JeanLeBris/Drone-Magnetic-Telepropulsion/README.md

# Télépropulsion magnétique

Réalisé par [Jean LE BRIS](https://github.com/JeanLeBris) et [Ewen MORVAN](https://github.com/EwenMorvan)

Teleprop_Technique

Pour obtenir les models 3d du système, cliquez [ici](https://grabcad.com/library/tele-propulsion-et-telecommande-magnetique-de-drones-de-surface-1).
