JeanLeBris/Drone-Magnetic-Telepropulsion/Documents/Images/ESP32 - pins - input.png

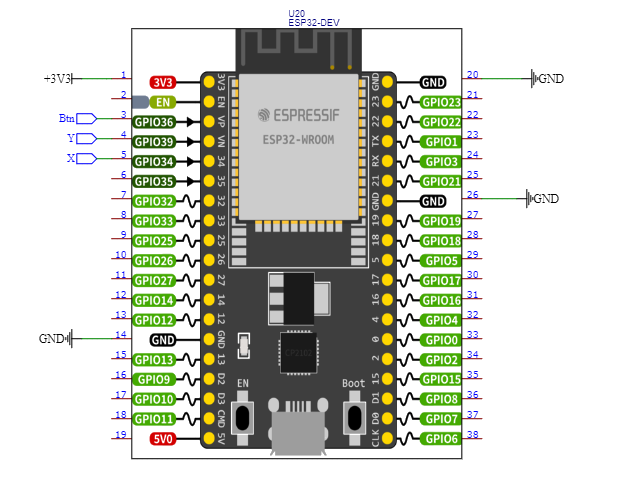
Documents/Images/ESP32 - pins - input.png
