JeanLeBris/Drone-Magnetic-Telepropulsion/Documents/Images/GifChampTournant/Proto1Img0.png

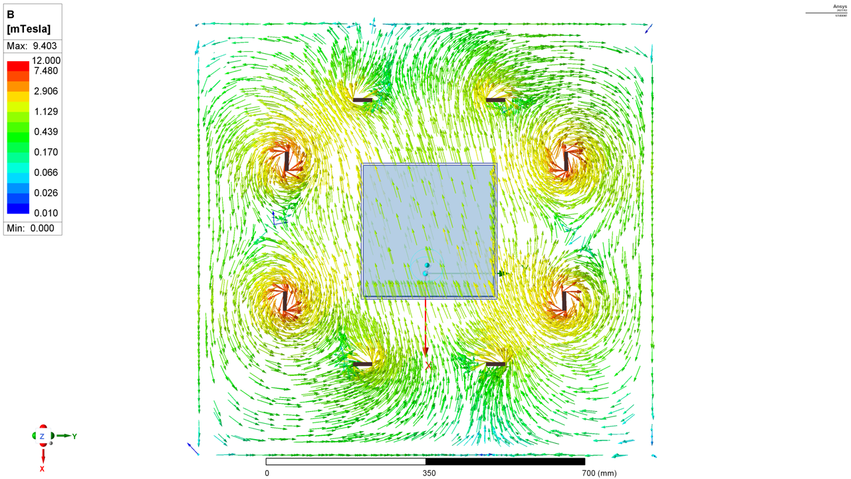
Documents/Images/GifChampTournant/Proto1Img0.png
