JeanLeBris/Drone-Magnetic-Telepropulsion/Documents/Images/GifChampTournant/Proto1Img8.png

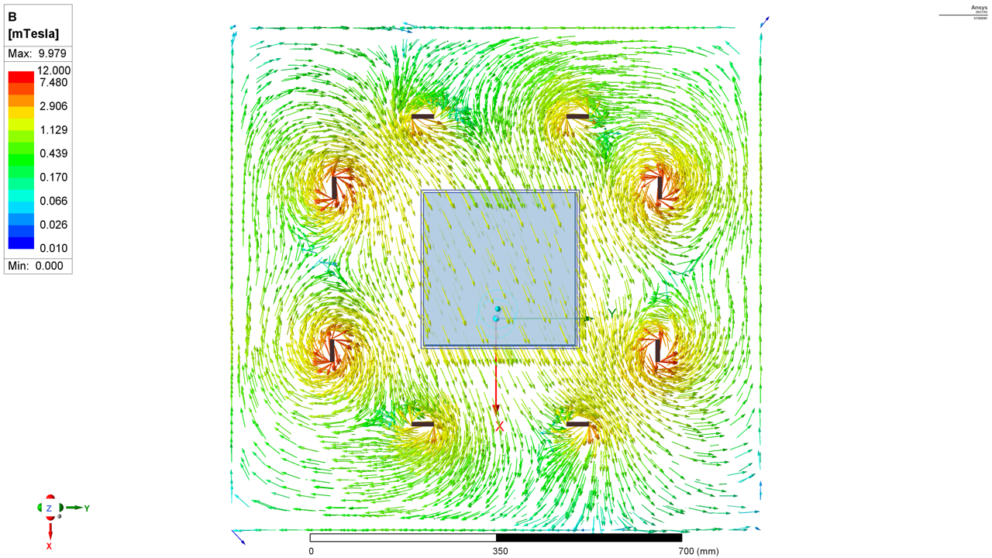
Documents/Images/GifChampTournant/Proto1Img8.png
