JeanLeBris/Drone-Magnetic-Telepropulsion/Documents/Images/GifChampTournant/Proto1Img10.png

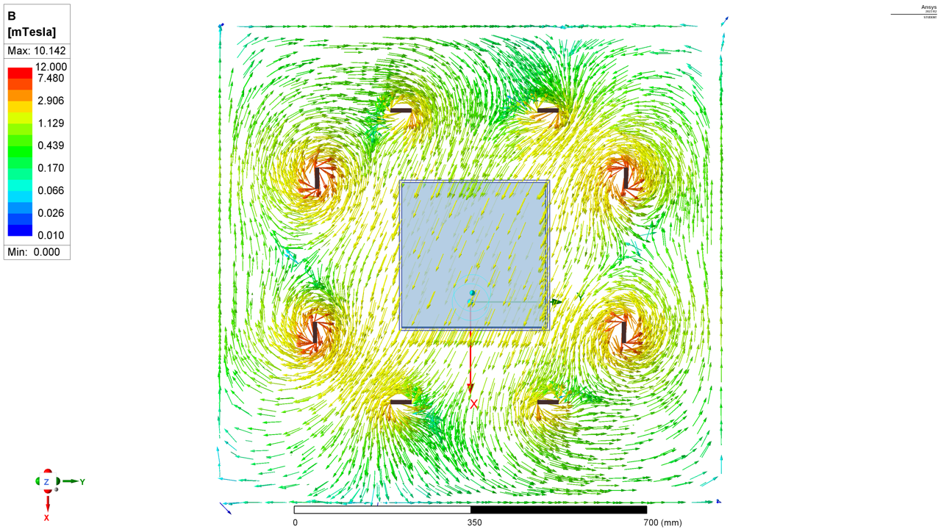
Documents/Images/GifChampTournant/Proto1Img10.png
