JeanLeBris/Drone-Magnetic-Telepropulsion/Documents/Images/GifChampTournant/Proto1Img14.png

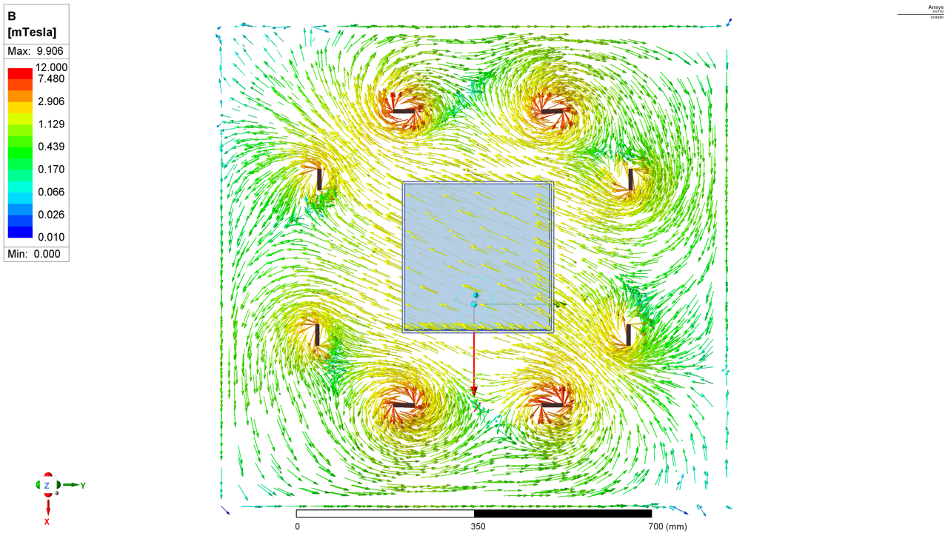
Documents/Images/GifChampTournant/Proto1Img14.png
