JeanLeBris/Drone-Magnetic-Telepropulsion/Documents/Images/gradient1.png

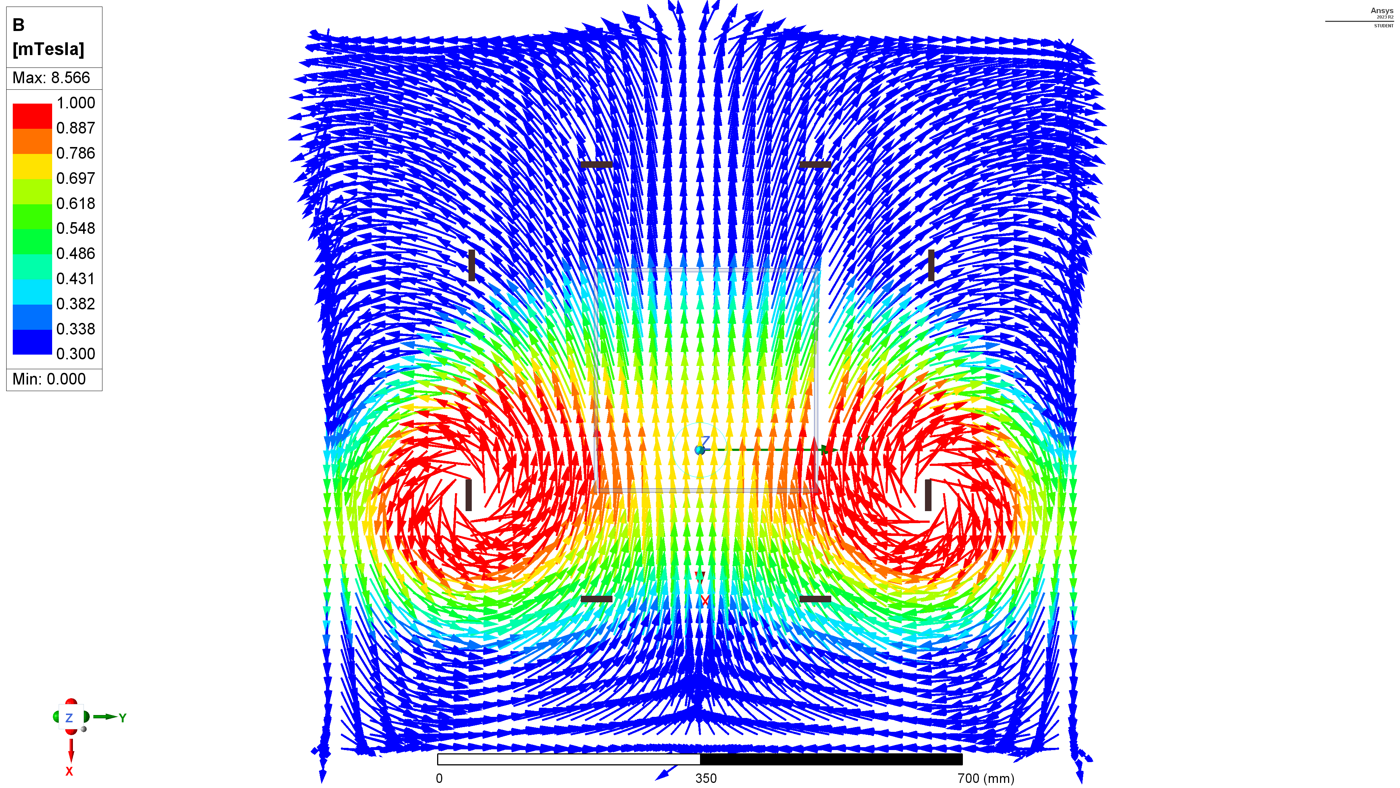
Documents/Images/gradient1.png
