JeanLeBris/Drone-Magnetic-Telepropulsion/Documents/Images/ImgPres.png

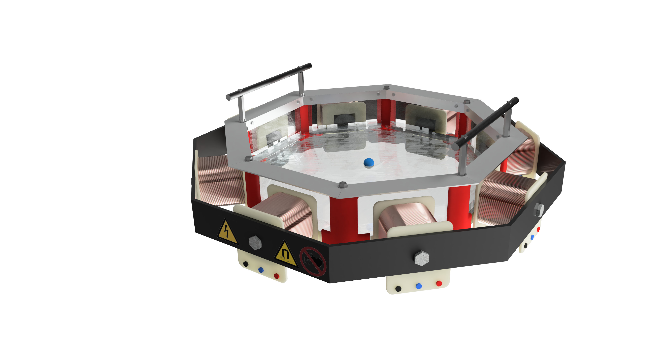
Documents/Images/ImgPres.png
