JeanLeBris/Drone-Magnetic-Telepropulsion/Documents/Images/PageGardeTemplate.png

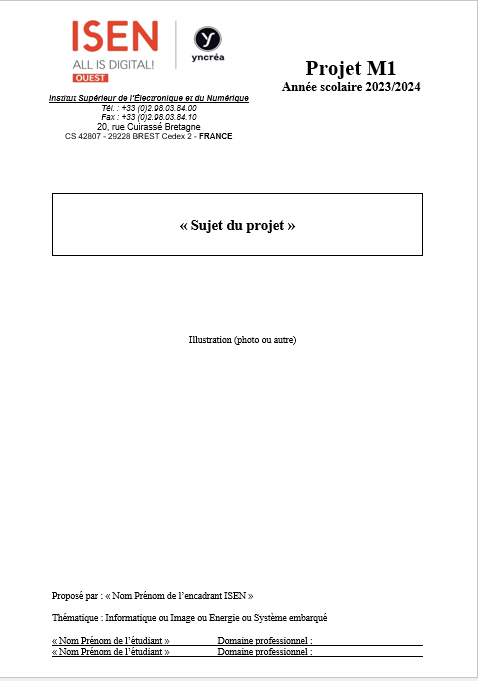
Documents/Images/PageGardeTemplate.png
