JeanLeBris/Drone-Magnetic-Telepropulsion/Documents/Images/view.jpg

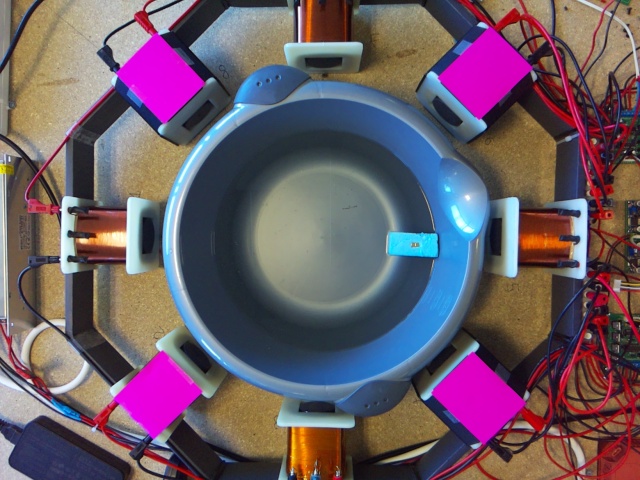
Documents/Images/view.jpg
