JeanLeBris/Drone-Magnetic-Telepropulsion/Power_Card/Constants.h

#ifndef CONSTANTS_H
#define CONSTANTS_H

#define PWM_0 32
#define PWM_1 33
#define PWM_2 25
#define PWM_3 26
#define PWM_4 27
#define PWM_5 14
#define PWM_6 12
#define PWM_7 13
const int PWM_pins[8] = {PWM_0, PWM_1, PWM_2, PWM_3, PWM_4, PWM_5, PWM_6, PWM_7};

#define DIR_0 15
#define DIR_1 2
#define DIR_2 0
#define DIR_3 4
#define DIR_4 5
#define DIR_5 18
#define DIR_6 19
#define DIR_7 23
const int dir_pins[8] = {DIR_0, DIR_1, DIR_2, DIR_3, DIR_4, DIR_5, DIR_6, DIR_7};

#define RX2 16
#define TX2 17

#define SDA 21
#define SCL 22

#define Btn 36
#define Y 39
#define X 34

#define DEBUG 1

#endif
