JeanLeBris/Drone-Magnetic-Telepropulsion/(commit log)

2024-03-23 Upload control card and power card codes
2024-03-23 update power card code
2024-03-28 calibrating colors
2024-04-04 update power card
2024-04-17 add debug constant to power card
